dhg26/EyeVu_Hardware_GM2/README.md

# EyeVu_Hardware_GM2
Design docs/designs for GM2 project - EyeVu Hardware

# Parts
- Raspberry Pi 4 - model B
- PiCam v3
