dhg26/EyeVu_Hardware_GM2/Final Product/CAD files/STLs & Images/Mechanism_image_isometric.jpg

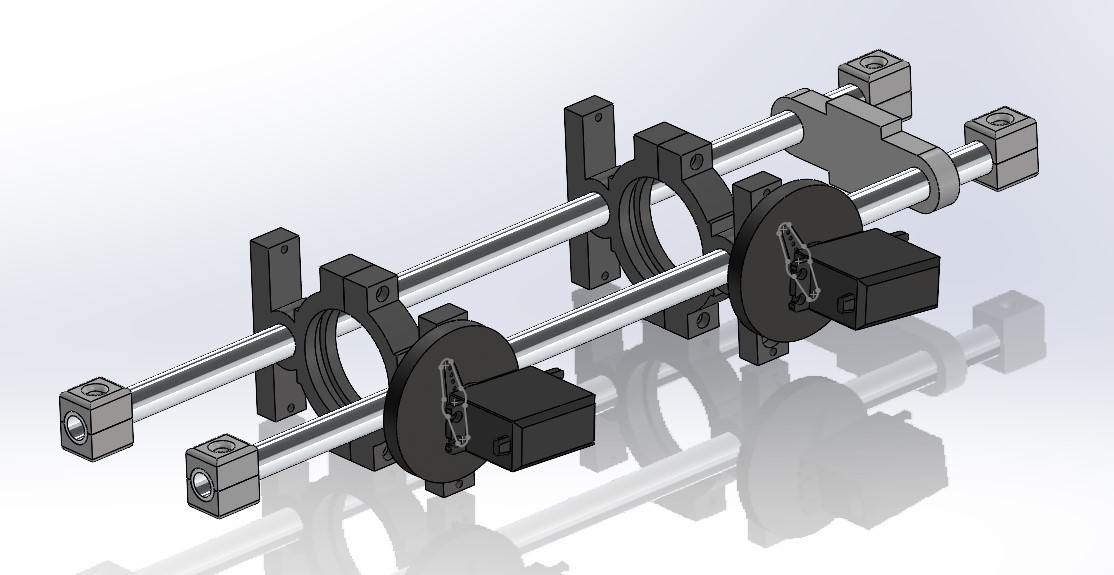
Final Product/CAD files/STLs & Images/Mechanism_image_isometric.jpg
