dhg26/EyeVu_Hardware_GM2/Testing Rig/CAD files/total assembly.SLDASM

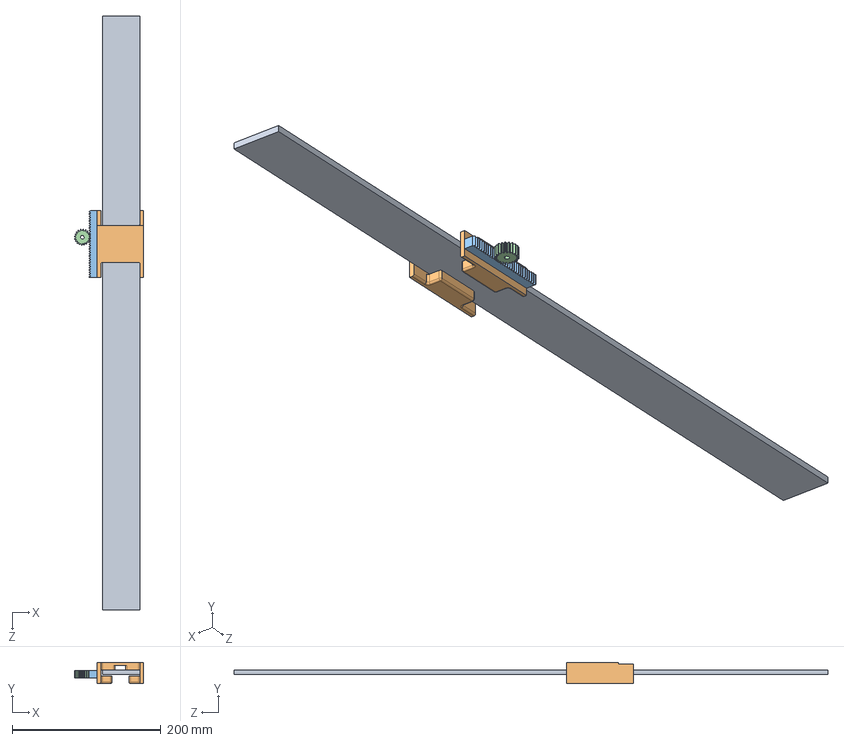
[picture p21: CAD file, 2023-06-08]
Testing Rig/CAD files/total assembly.SLDASM
93.5 x 28.4 x 800.0 mm
aluminium_rod
silder_fixed
rack spur rectangular_iso
spur gear_iso
