dhg26/EyeVu_Hardware_GM2/Alex's work/design_v2/total_assembly_v2.SLDASM

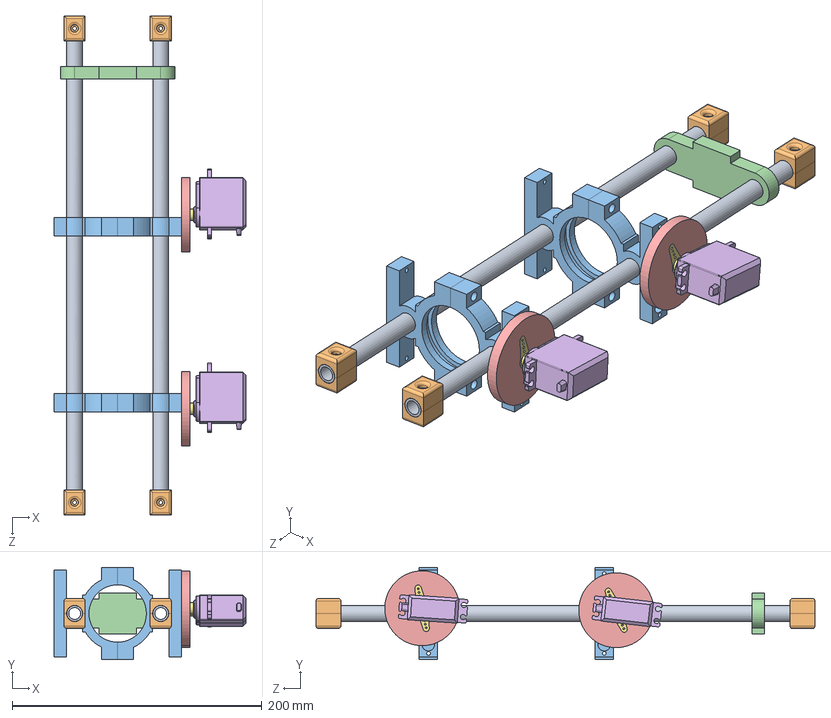
[picture p22: CAD file, 2023-06-08]
Alex's work/design_v2/total_assembly_v2.SLDASM
153.7 x 74.0 x 400.0 mm
alu_rod_19mm_OD x 2
end_bracket_upper x 8
lens_holder_half_modified x 4
camera_holder
mechanism_scotch x 2
MG995 servo motor (found online) x 2
MG995 servo motor horn (found online) x 2
