dhg26/EyeVu_Hardware_GM2/Alex's work/work/GN2_case_assembly.SLDASM

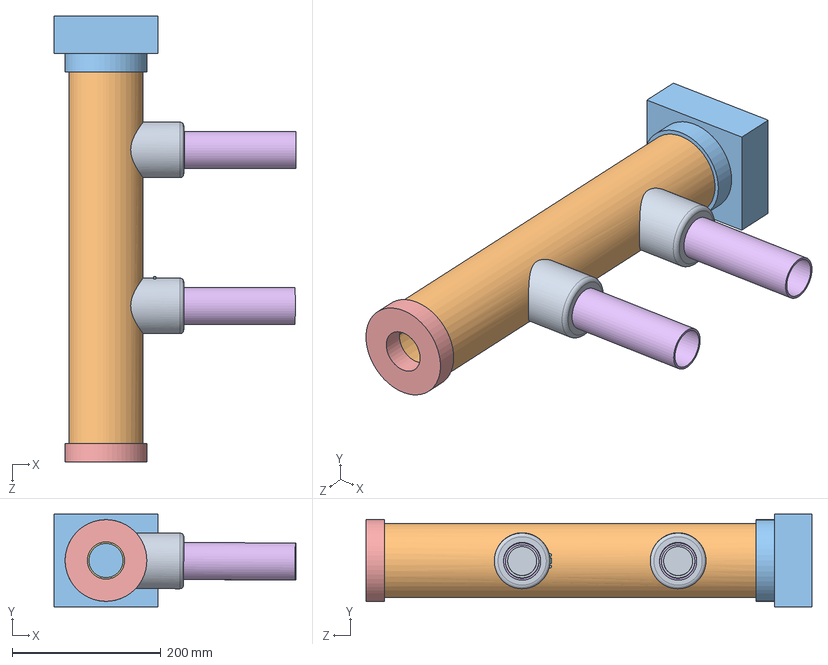
[picture p23: CAD file, 2023-06-08]
Alex's work/work/GN2_case_assembly.SLDASM
325.8 x 125.0 x 600.0 mm
GN2_endpiece2
GN2_rod x 2
GN2_pipe
GN2_handle x 2
GN2_endpiece
GN2_pvc_handle x 2
modified lens holder (only one sided mechanism) x 2
MG995 servo motor (found online)
