dhg26/EyeVu_Hardware_GM2/Testing Rig/CAD files/pinion_gear.SLDASM

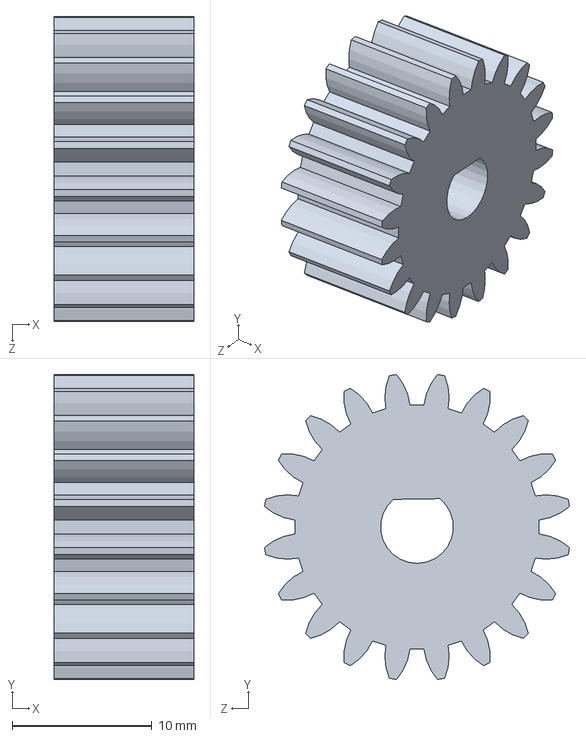
[picture p24: CAD file, 2023-06-08]
Testing Rig/CAD files/pinion_gear.SLDASM
10.0 x 21.8 x 21.8 mm
