dhg26/EyeVu_Hardware_GM2/Alex's work/design_v2/case_assembly.SLDASM

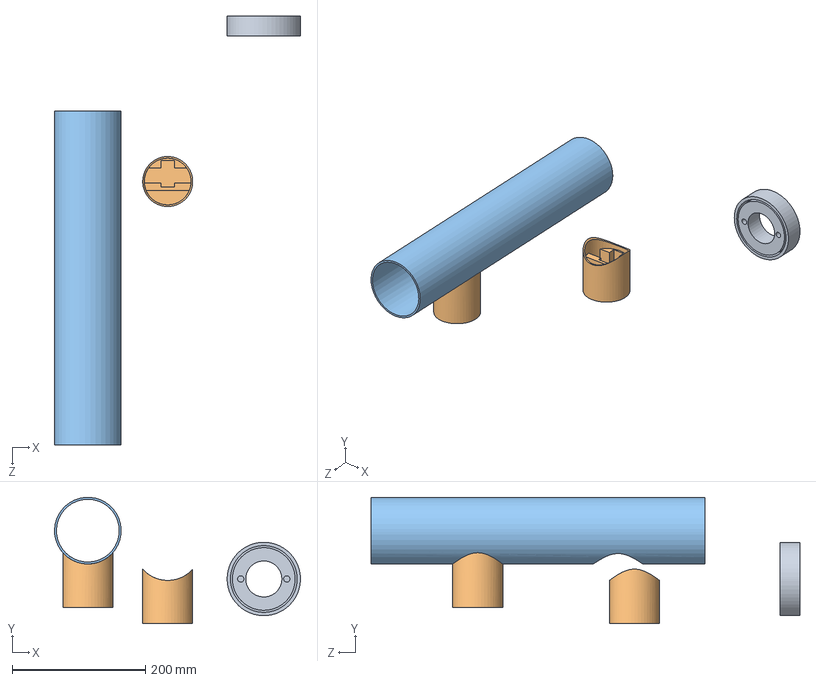
[picture p25: CAD file, 2023-06-08]
Alex's work/design_v2/case_assembly.SLDASM
368.6 x 189.2 x 642.4 mm
handle1 x 2
pipe
pipe_end_cap1
