dhg26/EyeVu_Hardware_GM2/Alex's work/work/square design/GN2_square_assembly.SLDASM

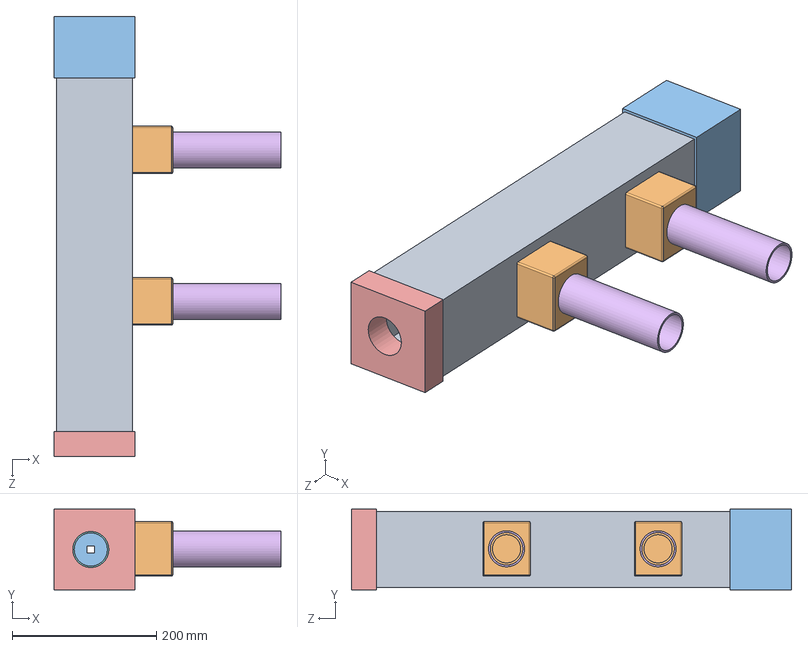
[picture p26: CAD file, 2023-06-08]
Alex's work/work/square design/GN2_square_assembly.SLDASM
314.6 x 112.0 x 610.0 mm
GN2_square_endcap2
GN2_square_handle x 2
GN2_square_pipe
GN2_square_rod x 2
GN2_square_endcap1
GN2_pvc_handle x 2
MG995 servo motor (found online) x 2
modified lens holder (only one sided mechanism) x 2
MG995 servo motor horn (found online) x 2
mechanism_scotch x 2
