dhg26/EyeVu_Hardware_GM2/Testing Rig/CAD files/rack.SLDASM

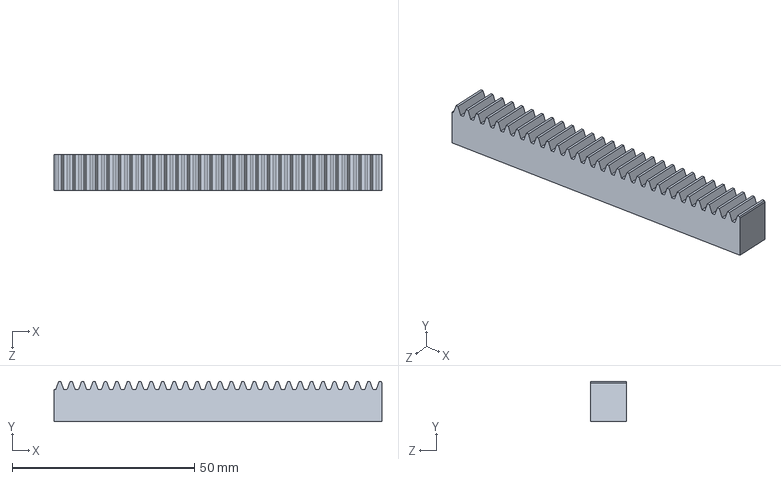
[picture p27: CAD file, 2023-05-28]
Testing Rig/CAD files/rack.SLDASM
90.0 x 11.0 x 10.0 mm
