dhg26/EyeVu_Hardware_GM2/Alex's work/design_v2/modified lens holder (only one sided mechanism).SLDPRT

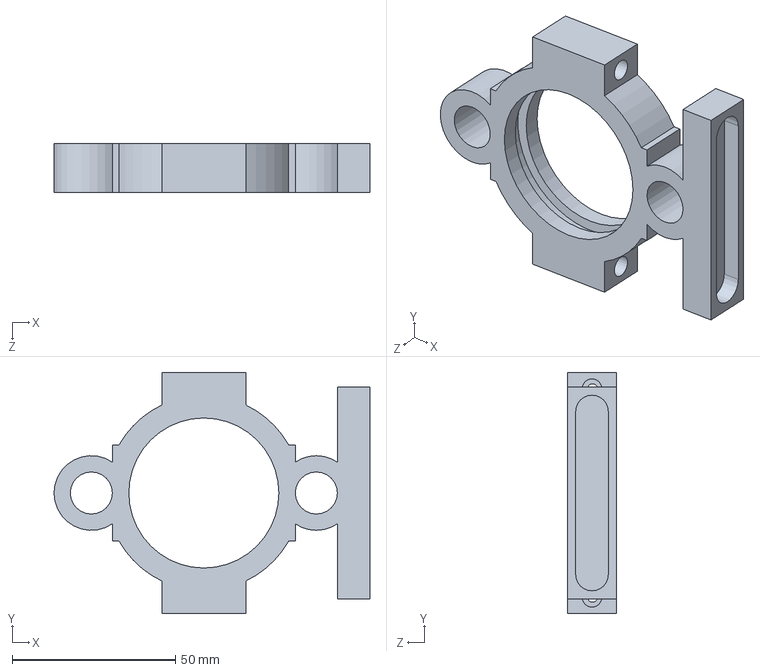
[picture p28: CAD file, 2023-06-08]
Alex's work/design_v2/modified lens holder (only one sided mechanism).SLDPRT
96.9 x 74.0 x 15.0 mm
