dhg26/EyeVu_Hardware_GM2/Alex's work/new/end support.STL

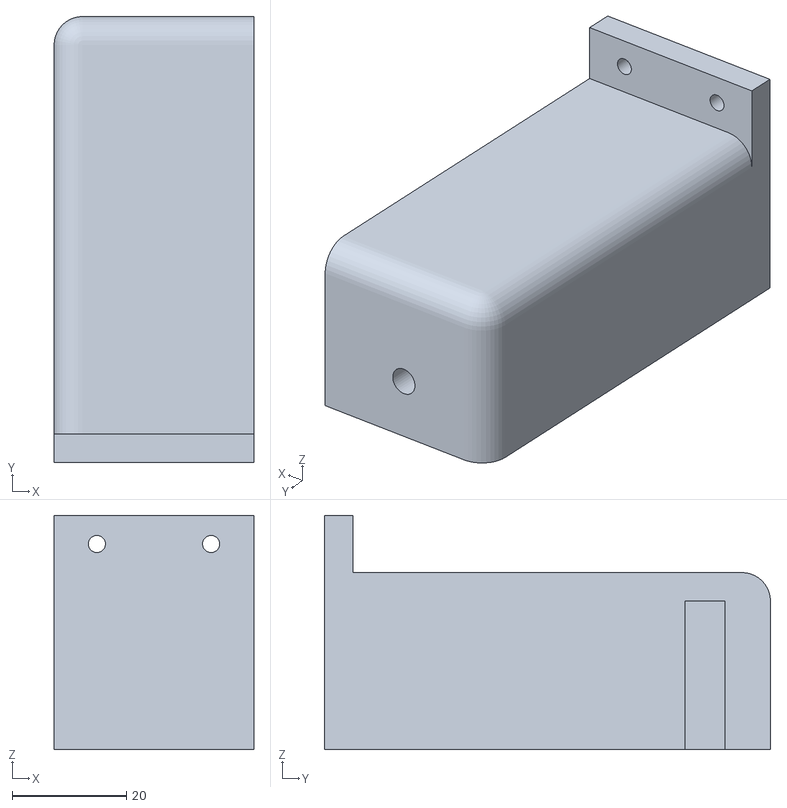
[picture p29: CAD file, 2023-06-08]
Alex's work/new/end support.STL
35.0 x 78.1 x 41.0
