dhg26/EyeVu_Hardware_GM2/Alex's work/work/GN2_endpiece2.SLDPRT

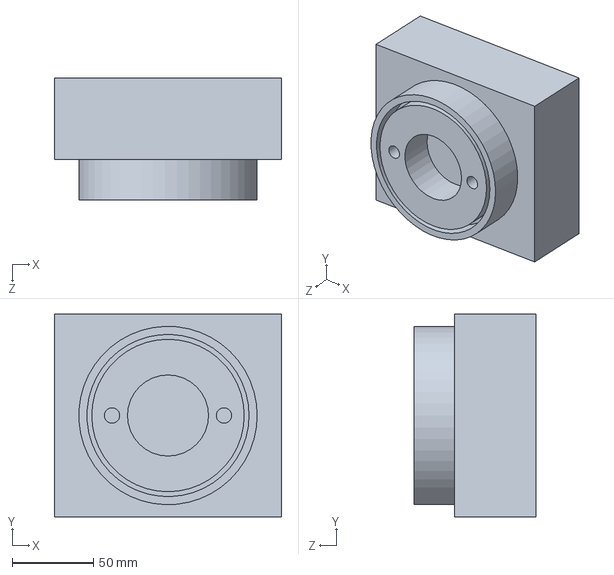
[picture p30: CAD file, 2023-06-08]
Alex's work/work/GN2_endpiece2.SLDPRT
140.0 x 125.0 x 75.0 mm
