dhg26/EyeVu_Hardware_GM2/Alex's work/work/square design/GN2_pvc_handle.SLDPRT

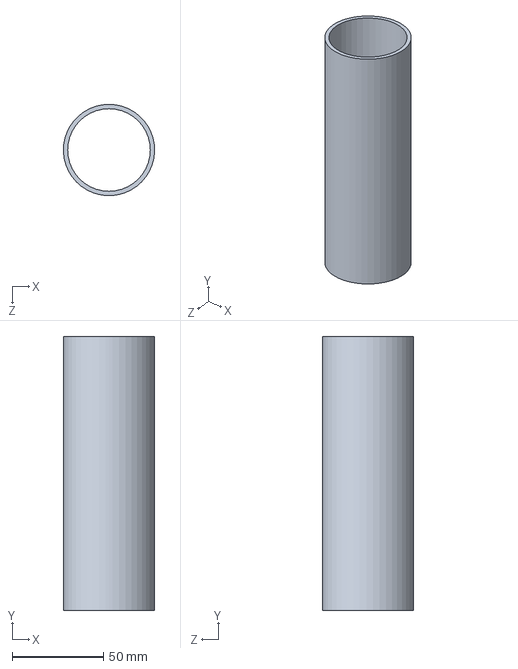
[picture p31: CAD file, 2023-06-08]
Alex's work/work/square design/GN2_pvc_handle.SLDPRT
50.0 x 150.0 x 50.0 mm
