dhg26/EyeVu_Hardware_GM2/Final Product/CAD files/lens_holder_half_w_yoke.SLDPRT

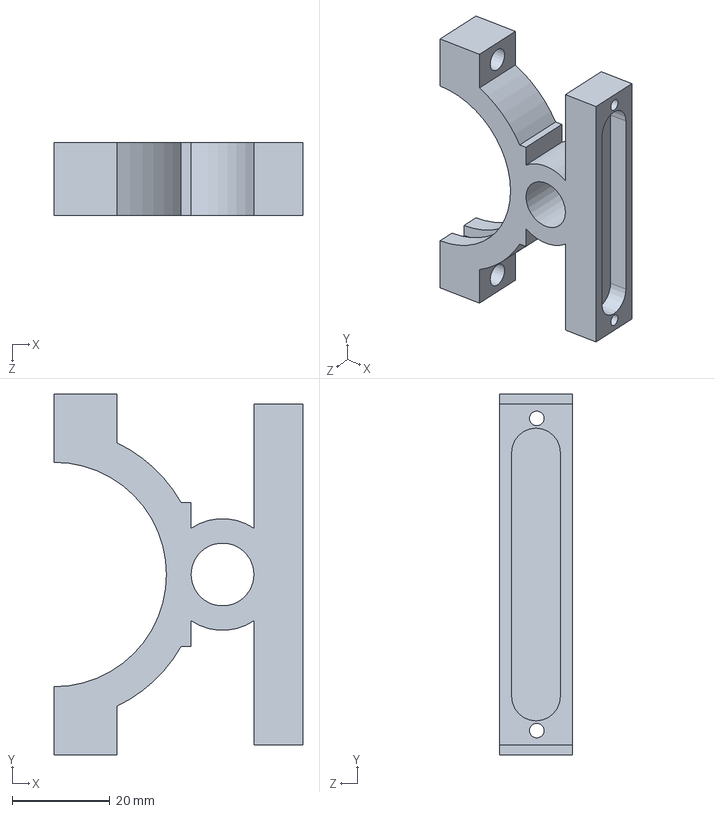
[picture p32: CAD file, 2023-06-08]
Final Product/CAD files/lens_holder_half_w_yoke.SLDPRT
51.0 x 74.0 x 15.0 mm
