dhg26/EyeVu_Hardware_GM2/Final Product/CAD files/STLs & Images/tube_holder_half.STL

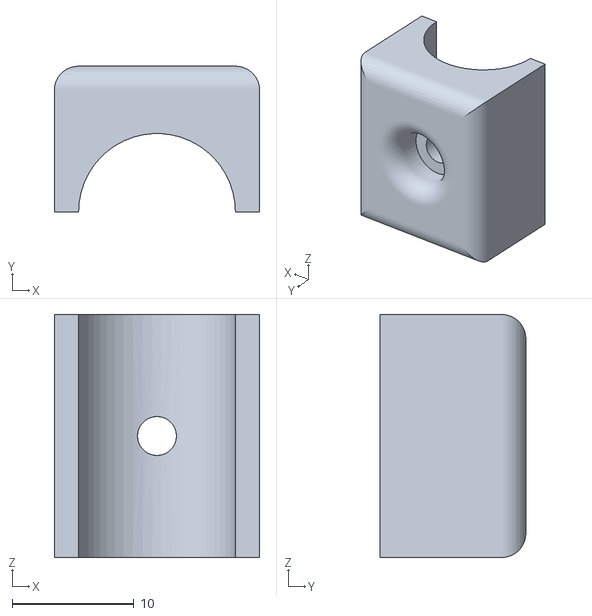
[picture p33: CAD file, 2023-06-08]
Final Product/CAD files/STLs & Images/tube_holder_half.STL
16.9 x 12.0 x 20.0
