dhg26/EyeVu_Hardware_GM2/Alex's work/work/square design/GN2_square_pipe.SLDPRT

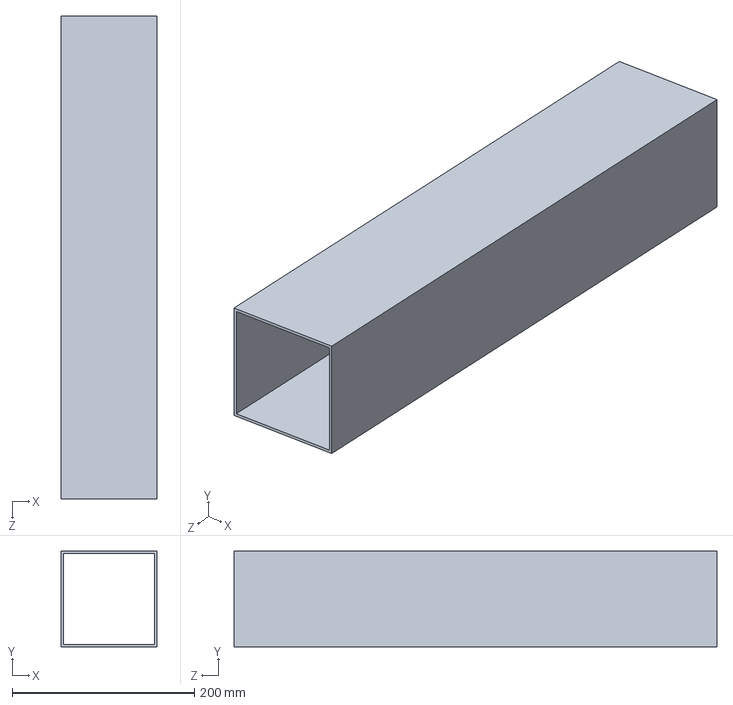
[picture p34: CAD file, 2023-06-08]
Alex's work/work/square design/GN2_square_pipe.SLDPRT
105.0 x 105.0 x 530.0 mm
