dhg26/EyeVu_Hardware_GM2/Final Product/CAD files/disk_w_scotch.SLDPRT

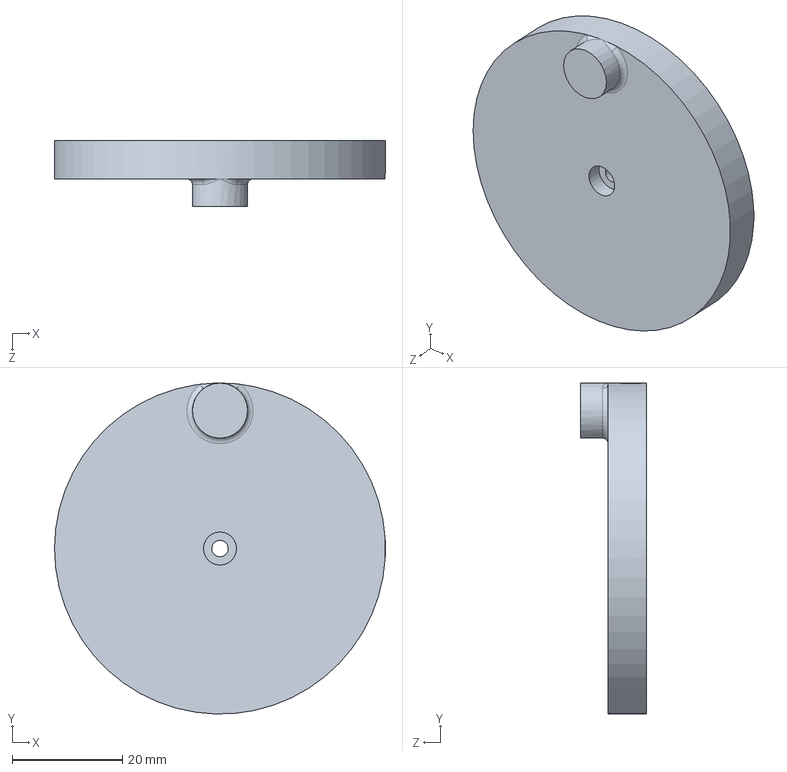
[picture p35: CAD file, 2023-06-08]
Final Product/CAD files/disk_w_scotch.SLDPRT
60.0 x 60.0 x 12.0 mm
