dhg26/EyeVu_Hardware_GM2/Final Product/CAD files/STLs & Images/camera_holder.STL

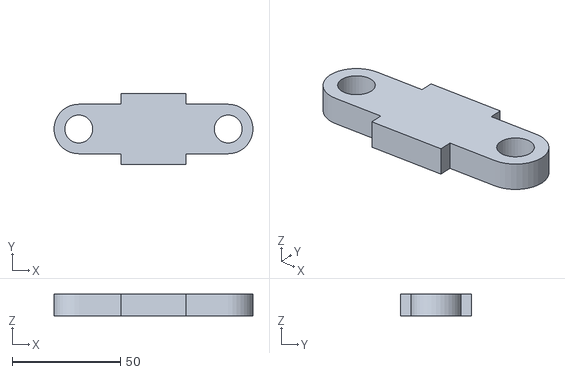
[picture p36: CAD file, 2023-06-08]
Final Product/CAD files/STLs & Images/camera_holder.STL
91.9 x 32.9 x 10.0
