dhg26/EyeVu_Hardware_GM2/Alex's work/design_v2/pipe_end_cap1.SLDPRT

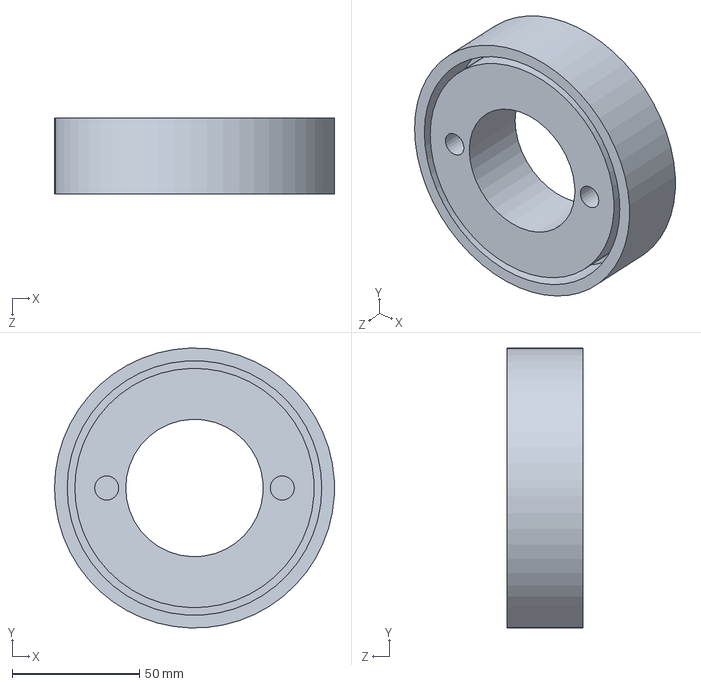
[picture p37: CAD file, 2023-06-08]
Alex's work/design_v2/pipe_end_cap1.SLDPRT
110.0 x 110.0 x 30.0 mm
