dhg26/EyeVu_Hardware_GM2/Alex's work/work/GN2_rod.SLDPRT

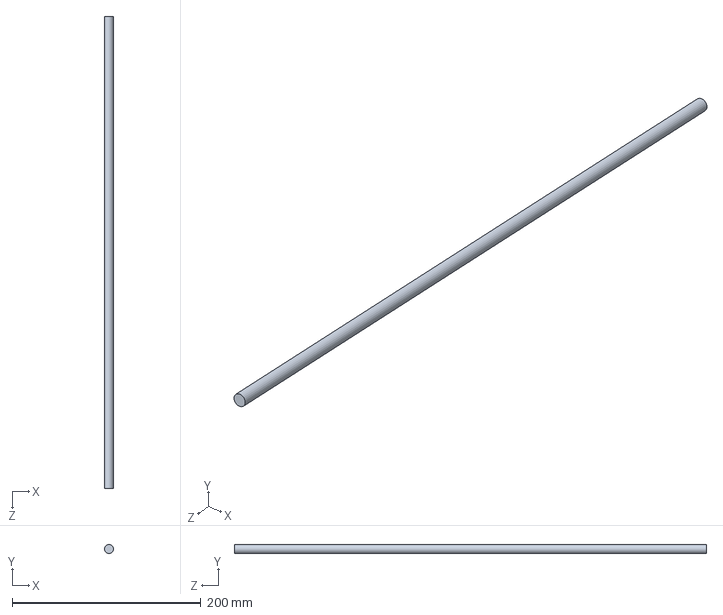
[picture p38: CAD file, 2023-06-08]
Alex's work/work/GN2_rod.SLDPRT
9.50 x 9.50 x 500.0 mm
