dhg26/EyeVu_Hardware_GM2/Alex's work/work/square design/GN2_square_handle.SLDPRT

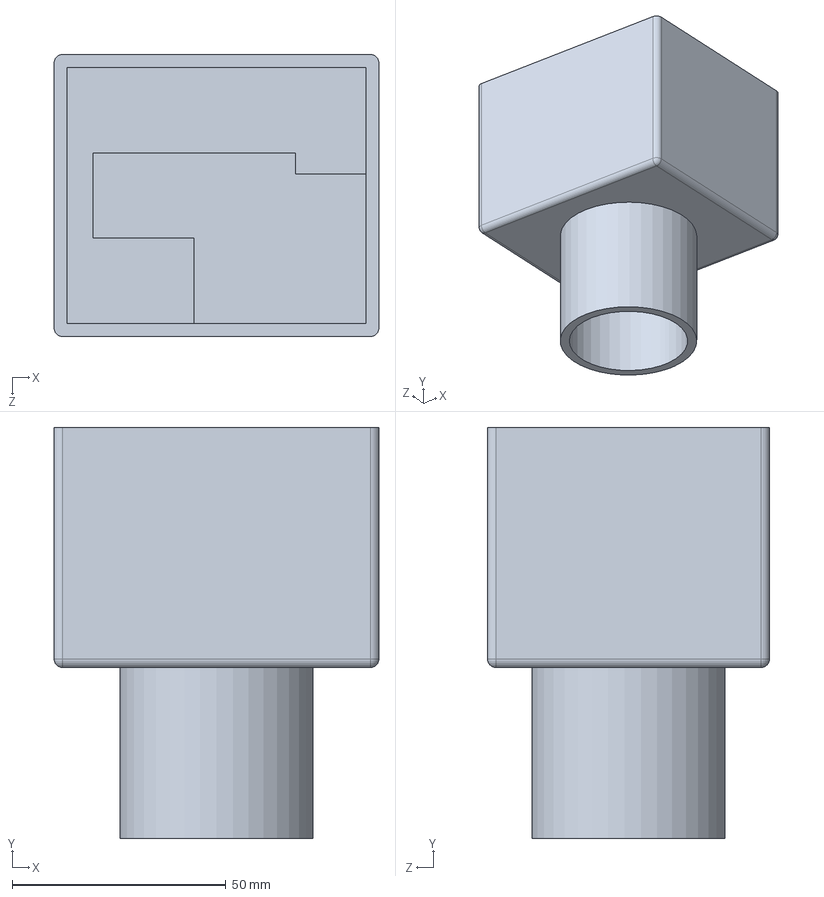
[picture p39: CAD file, 2023-06-08]
Alex's work/work/square design/GN2_square_handle.SLDPRT
76.0 x 96.2 x 66.0 mm
