dhg26/EyeVu_Hardware_GM2/Final Product/CAD files/aluminium_tube.SLDPRT

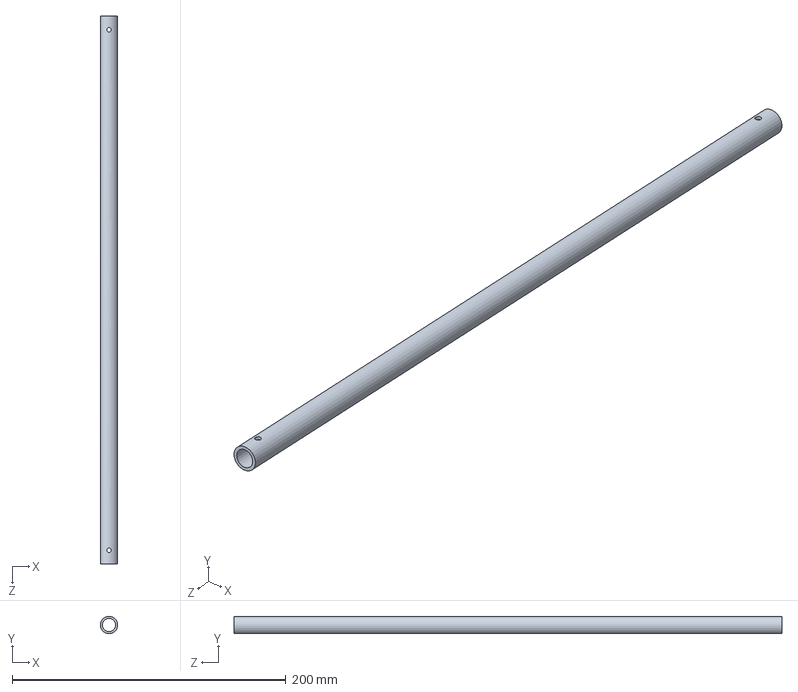
[picture p40: CAD file, 2023-06-08]
Final Product/CAD files/aluminium_tube.SLDPRT
12.7 x 12.7 x 400.0 mm
