dhg26/EyeVu_Hardware_GM2/Testing Rig/CAD files/silder_fixed.SLDPRT

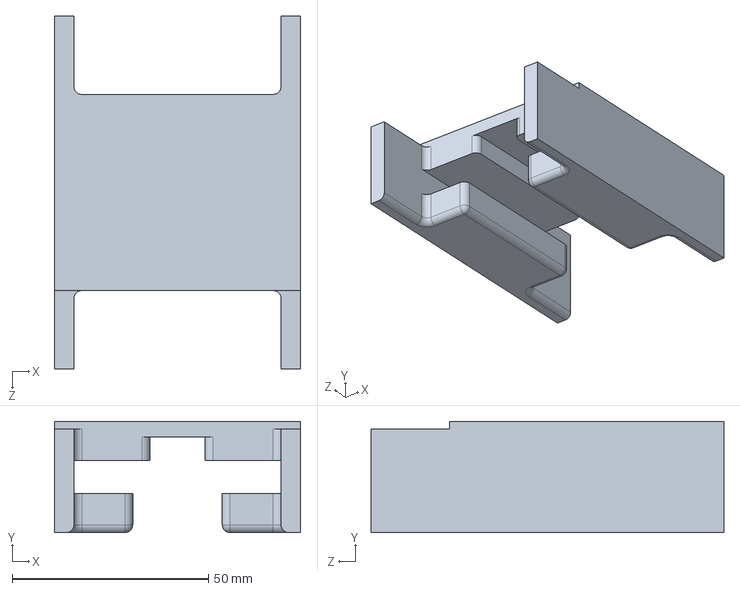
[picture p41: CAD file, 2023-06-08]
Testing Rig/CAD files/silder_fixed.SLDPRT
62.8 x 28.4 x 90.0 mm
