dhg26/EyeVu_Hardware_GM2/Alex's work/new/middle support.SLDPRT

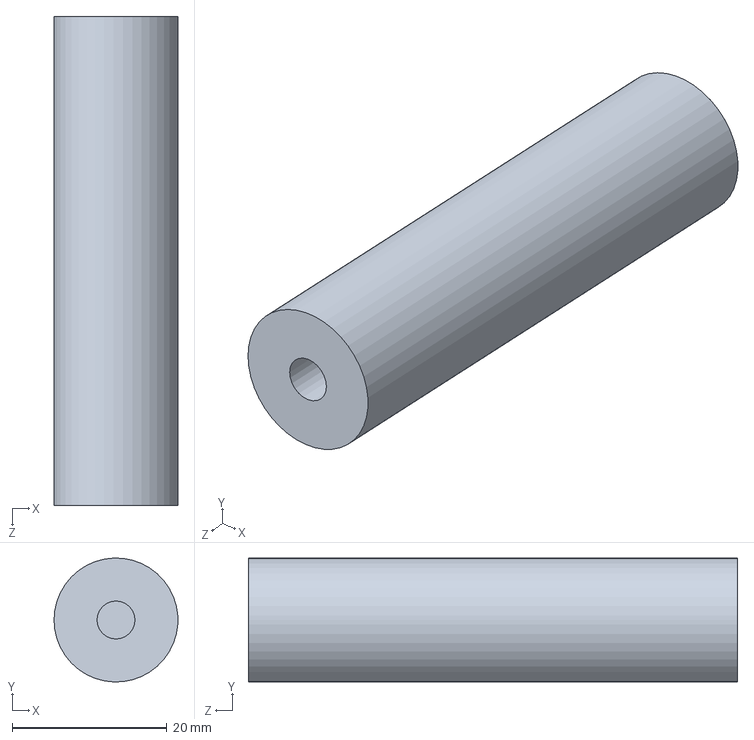
[picture p42: CAD file, 2023-06-01]
Alex's work/new/middle support.SLDPRT
16.0 x 16.0 x 63.1 mm
