dhg26/EyeVu_Hardware_GM2/Testing Rig/CAD files/lens_holder_right_for_auto.SLDPRT

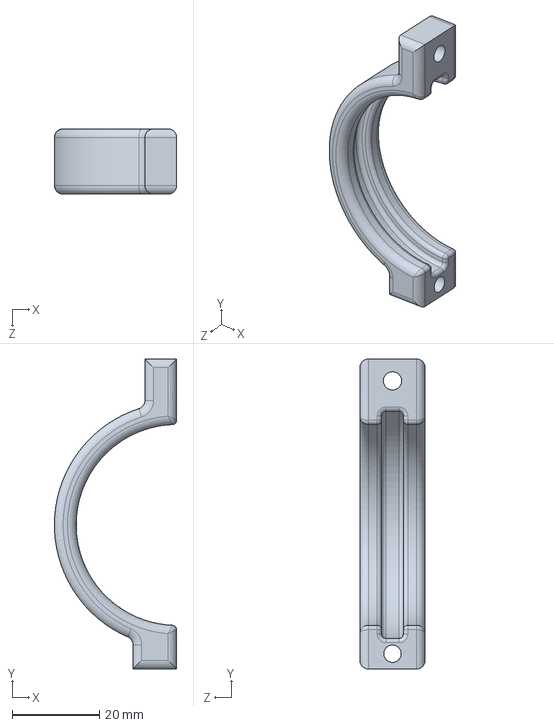
[picture p43: CAD file, 2023-06-08]
Testing Rig/CAD files/lens_holder_right_for_auto.SLDPRT
28.0 x 71.0 x 15.0 mm
