dhg26/EyeVu_Hardware_GM2/Alex's work/new/motorised base plate corrected.DXF

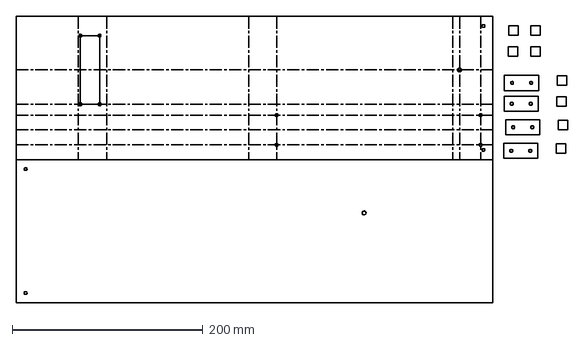
[picture p44: CAD file, 2023-06-01]
Alex's work/new/motorised base plate corrected.DXF
578.7 x 300.0 mm
