dhg26/EyeVu_Hardware_GM2/Alex's work/work/GN2_endpiece.SLDPRT

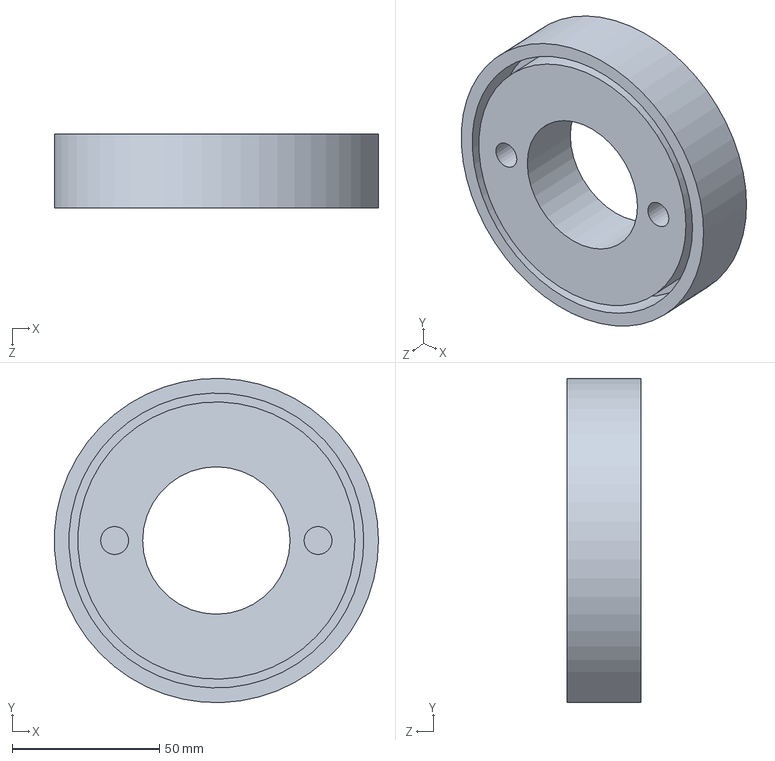
[picture p45: CAD file, 2023-06-08]
Alex's work/work/GN2_endpiece.SLDPRT
109.9 x 110.0 x 25.0 mm
