dhg26/EyeVu_Hardware_GM2/Alex's work/work/square design/GN2_square_rod.SLDPRT

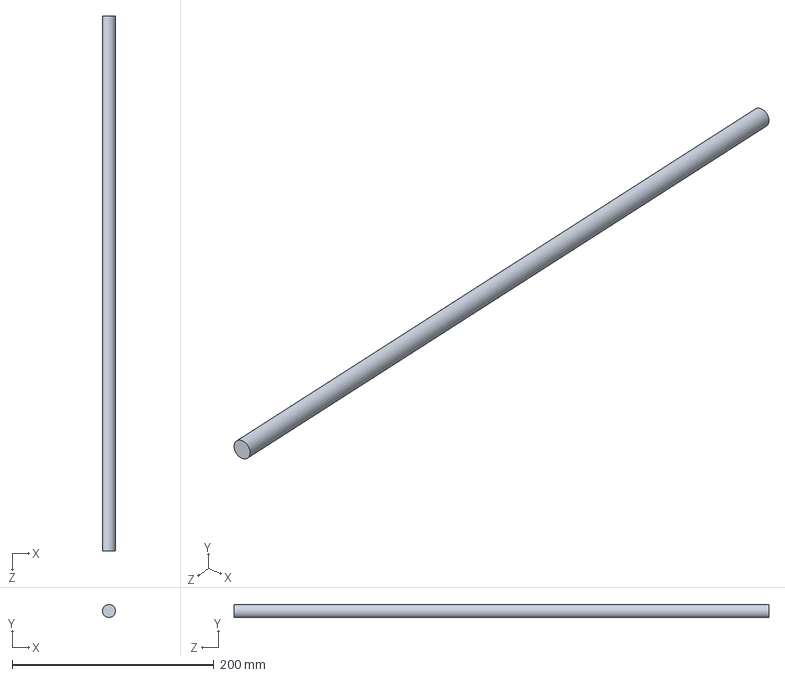
[picture p46: CAD file, 2023-06-08]
Alex's work/work/square design/GN2_square_rod.SLDPRT
12.9 x 12.9 x 530.0 mm
