dhg26/EyeVu_Hardware_GM2/Testing Rig/CAD files/lens_holder_left_for_auto.SLDPRT

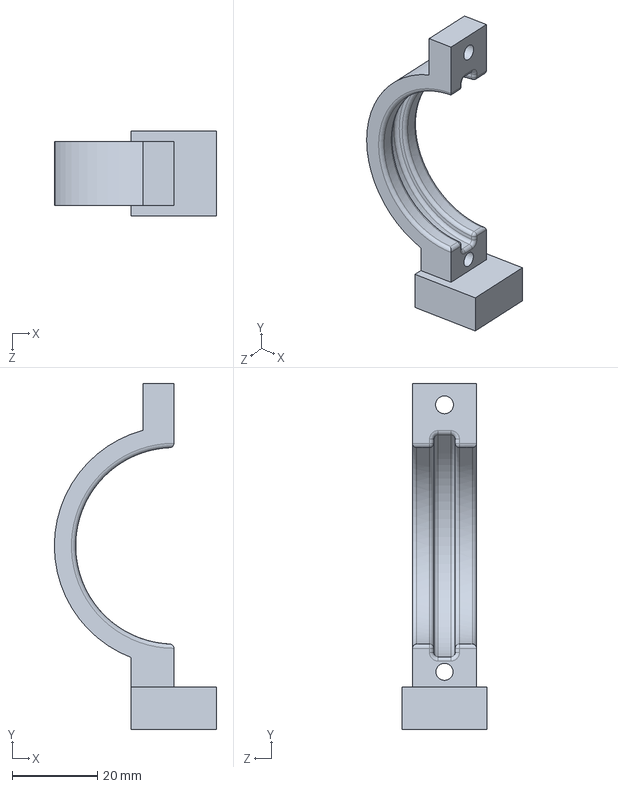
[picture p47: CAD file, 2023-06-08]
Testing Rig/CAD files/lens_holder_left_for_auto.SLDPRT
38.0 x 81.0 x 20.0 mm
