dhg26/EyeVu_Hardware_GM2/Alex's work/design_v2/pipe.SLDPRT

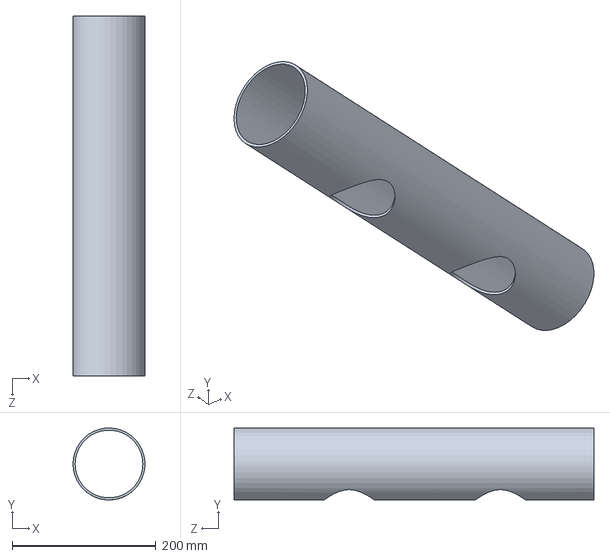
[picture p48: CAD file, 2023-06-08]
Alex's work/design_v2/pipe.SLDPRT
100.0 x 100.0 x 500.0 mm
