dhg26/EyeVu_Hardware_GM2/Alex's work/new/Part2.SLDPRT

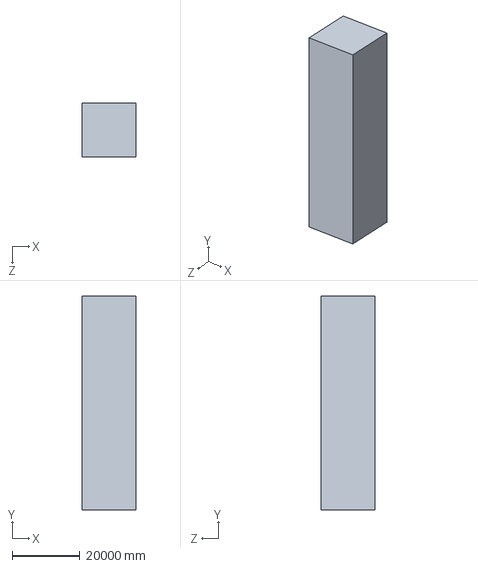
[picture p49: CAD file, 2023-06-01]
Alex's work/new/Part2.SLDPRT
16000.0 x 63100.0 x 16000.0 mm
