dhg26/EyeVu_Hardware_GM2/Alex's work/work/GN2_pipe.SLDPRT

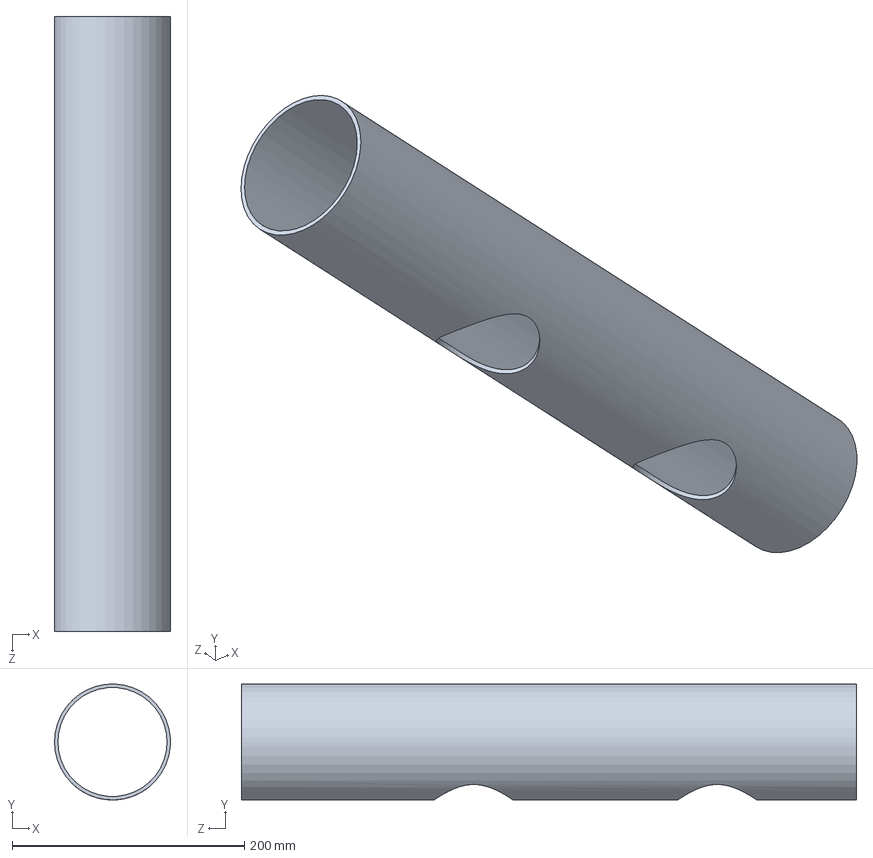
[picture p50: CAD file, 2023-06-08]
Alex's work/work/GN2_pipe.SLDPRT
100.0 x 100.0 x 530.0 mm
