dhg26/EyeVu_Hardware_GM2/Alex's work/design_v2/handle1.SLDPRT

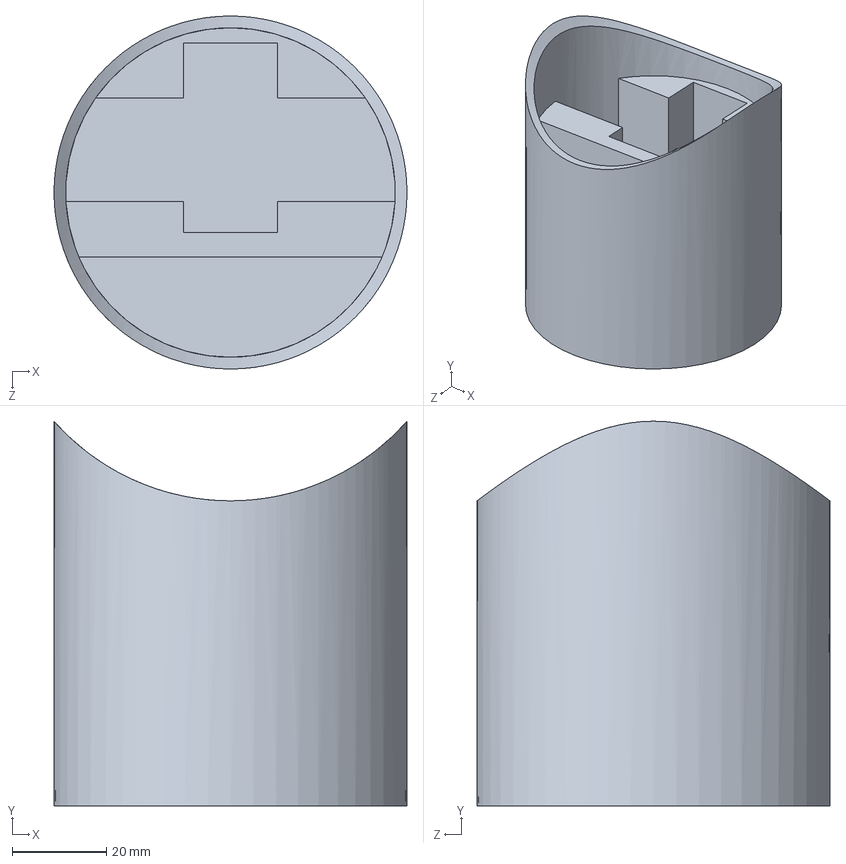
[picture p52: CAD file, 2023-06-08]
Alex's work/design_v2/handle1.SLDPRT
75.0 x 81.7 x 75.0 mm
