dhg26/EyeVu_Hardware_GM2/Alex's work/new/motorised base plate.DXF

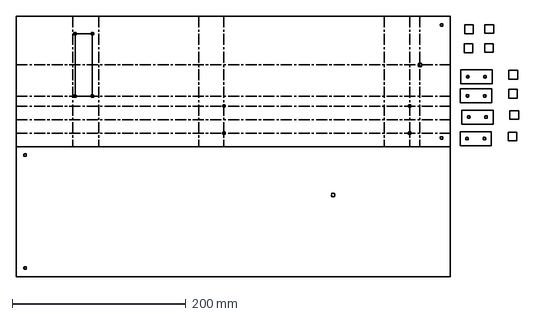
[picture p53: CAD file, 2023-06-01]
Alex's work/new/motorised base plate.DXF
578.7 x 300.0 mm
