dhg26/EyeVu_Hardware_GM2/Alex's work/work/GN2_handle.SLDPRT

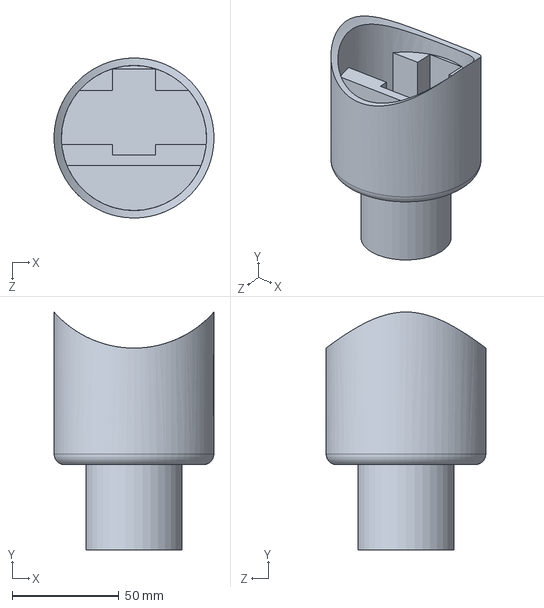
[picture p54: CAD file, 2023-06-08]
Alex's work/work/GN2_handle.SLDPRT
75.0 x 111.6 x 75.0 mm
