dhg26/EyeVu_Hardware_GM2/Alex's work/work/square design/GN2_square_endcap1.SLDPRT

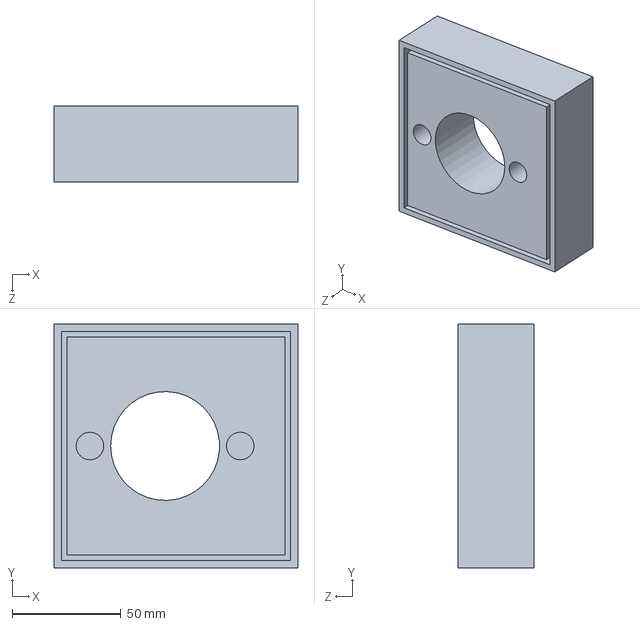
[picture p55: CAD file, 2023-06-08]
Alex's work/work/square design/GN2_square_endcap1.SLDPRT
112.0 x 112.0 x 35.0 mm
