dhg26/EyeVu_Hardware_GM2/Testing Rig/CAD files/aluminium_rod.SLDPRT

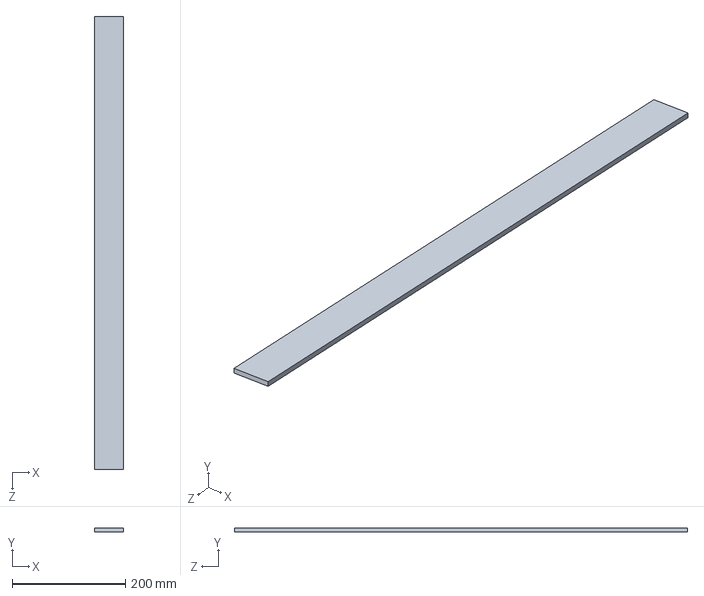
[picture p56: CAD file, 2023-05-28]
Testing Rig/CAD files/aluminium_rod.SLDPRT
50.8 x 6.35 x 800.0 mm
