dhg26/EyeVu_Hardware_GM2/Alex's work/new/motorholder.SLDPRT

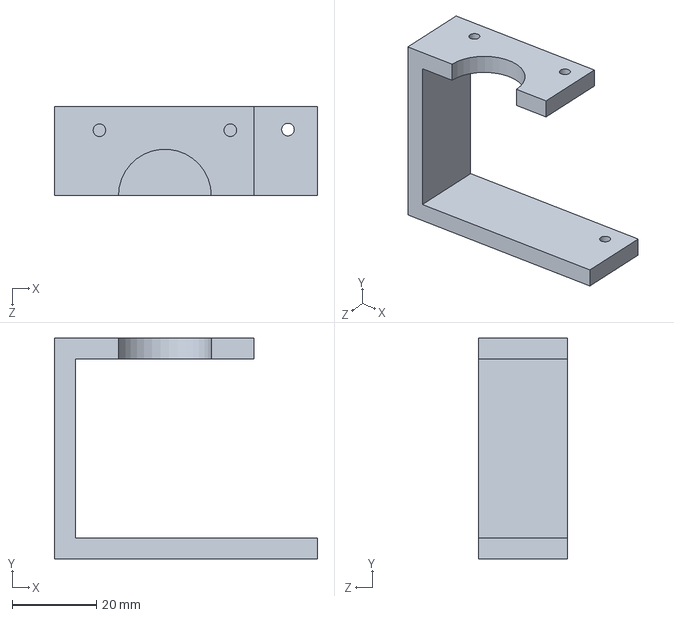
[picture p57: CAD file, 2023-06-01]
Alex's work/new/motorholder.SLDPRT
62.3 x 52.3 x 21.1 mm
