dhg26/EyeVu_Hardware_GM2/Final Product/CAD files/50mm_biconvex_lens_model.SLDPRT

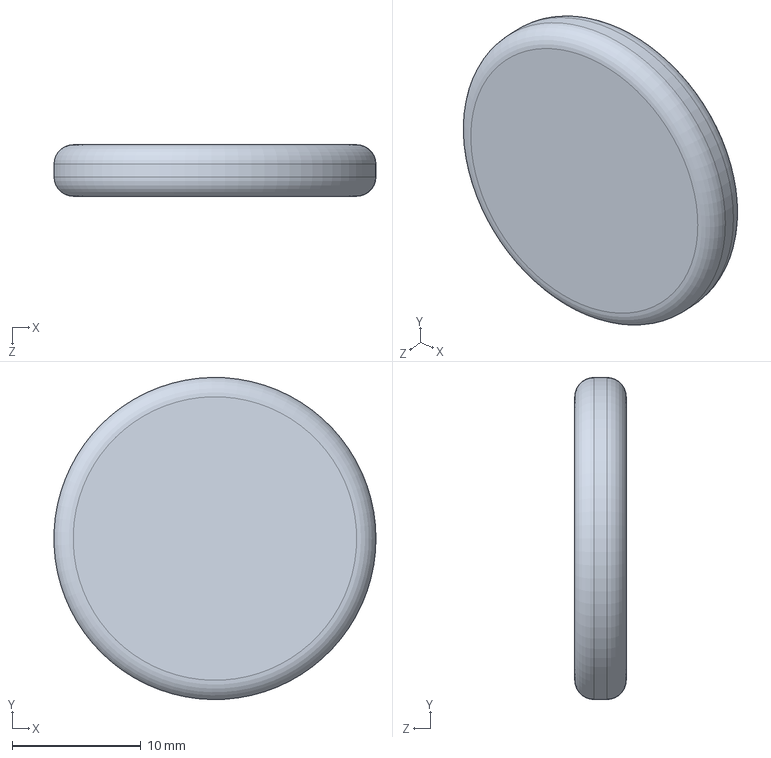
[picture p58: CAD file, 2023-06-08]
Final Product/CAD files/50mm_biconvex_lens_model.SLDPRT
25.0 x 25.0 x 4.00 mm
