dhg26/EyeVu_Hardware_GM2/Alex's work/design_v2/MG995 servo motor horn (found online) .SLDPRT

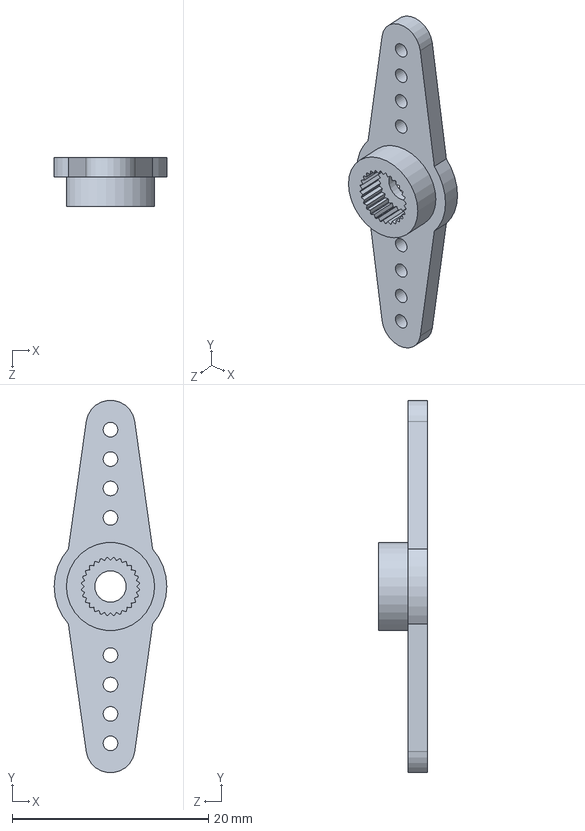
[picture p59: CAD file, 2023-06-08]
Alex's work/design_v2/MG995 servo motor horn (found online) .SLDPRT
11.5 x 38.0 x 5.00 mm
