dhg26/EyeVu_Hardware_GM2/Testing Rig/CAD files/lens_holder_left.SLDPRT

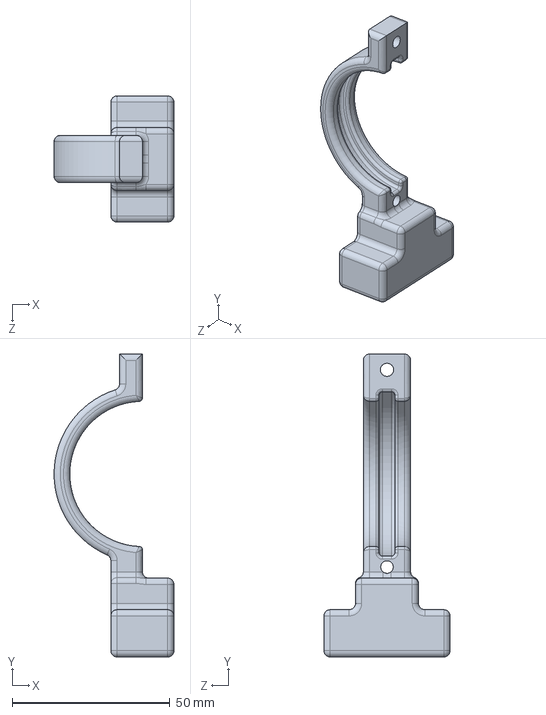
[picture p60: CAD file, 2023-05-28]
Testing Rig/CAD files/lens_holder_left.SLDPRT
38.0 x 96.0 x 40.0 mm
