dhg26/EyeVu_Hardware_GM2/Alex's work/design_v2/MG995 servo motor (found online).sldprt

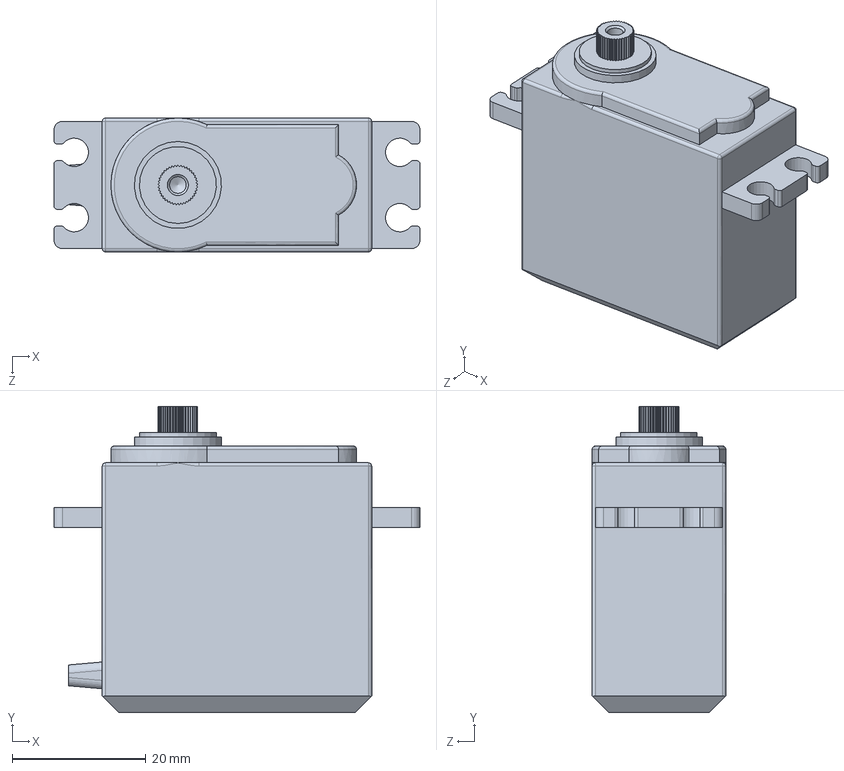
[picture p61: CAD file, 2023-06-08]
Alex's work/design_v2/MG995 servo motor (found online).sldprt
54.7 x 45.7 x 20.0 mm
