dhg26/EyeVu_Hardware_GM2/Testing Rig/CAD files/camera_mount.SLDPRT

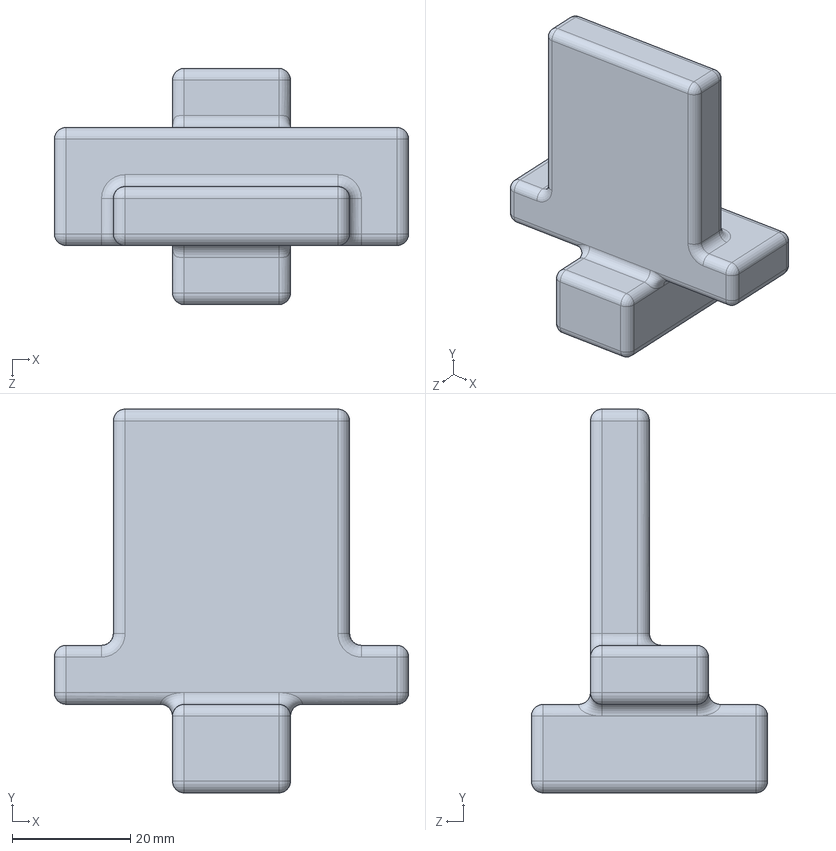
[picture p62: CAD file, 2023-05-28]
Testing Rig/CAD files/camera_mount.SLDPRT
60.0 x 65.0 x 40.0 mm
