dhg26/EyeVu_Hardware_GM2/(list of files, cad)

Other CAD files:
Final Product/CAD files/total_assembly.SLDASM
Alex's work/motorised base plate corrected.SLDPRT
Alex's work/motorised base plate.SLDPRT
Alex's work/new/test base plate static.SLDPRT
Alex's work/new/end holder.SLDPRT
Final Product/CAD files/STLs & Images/disk_w_scotch.STL
Alex's work/work/GN2_pvc_handle.SLDPRT
Final Product/CAD files/STLs & Images/lens_holder_half_w_yoke.STL
Alex's work/design_v2/rail.SLDPRT
Final Product/CAD files/modified lens holder (only one sided mechanism).SLDPRT
Final Product/CAD files/camera_holder.SLDPRT
Final Product/CAD files/tube_holder_half.SLDPRT
Alex's work/design_v2/mechanism_scotch.SLDPRT
Testing Rig/CAD files/lens_holder_right.SLDPRT
Alex's work/new/end holder.STL
Alex's work/new/middle support.STL
Alex's work/new/motorholder.STL
