dhg26/EyeVu_Hardware_GM2/Testing Rig/block diagram of full system.pdf

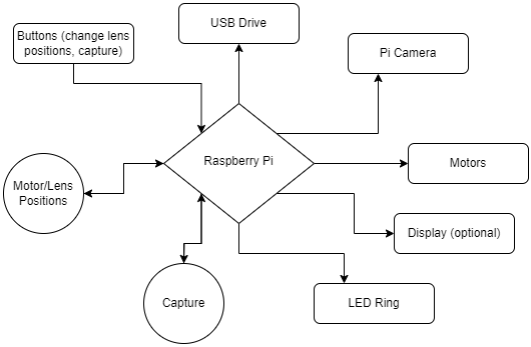
[picture p69: figure]
