dhg26/EyeVu_Hardware_GM2/Testing Rig/Photos/2023-05-31-173207_2560x1440_scrot.png

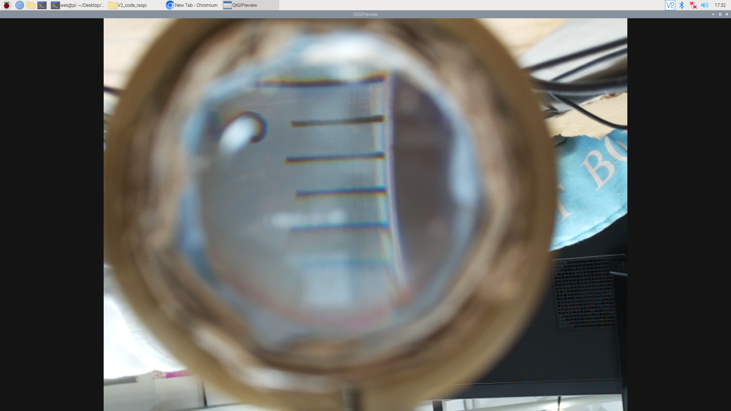
Testing Rig/Photos/2023-05-31-173207_2560x1440_scrot.png
