dhg26/EyeVu_Hardware_GM2/Testing Rig/Photos/2023-06-01-120918_2560x1440_scrot.png

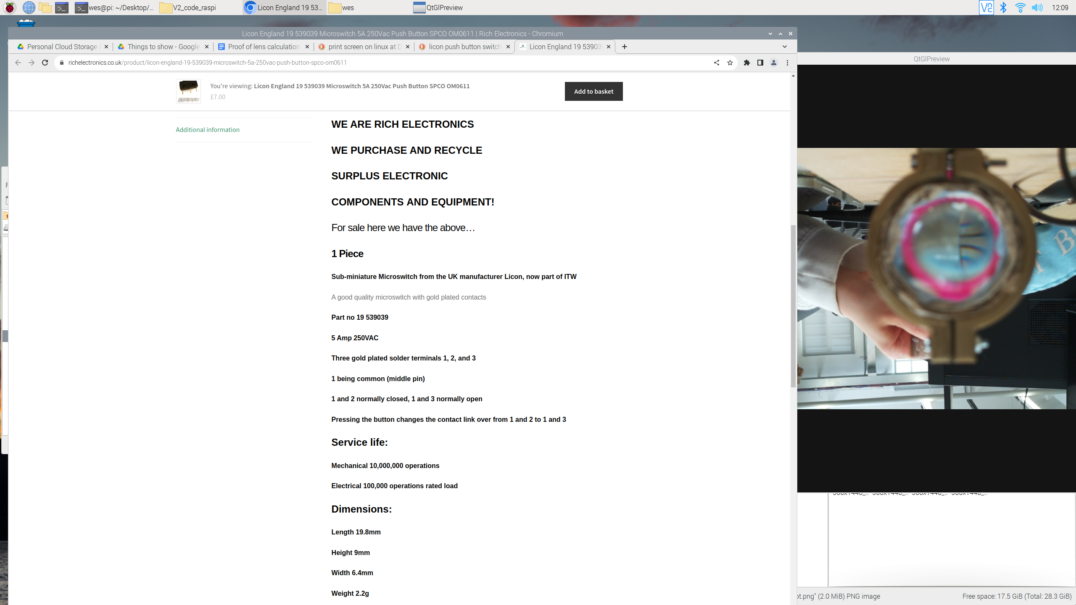
Testing Rig/Photos/2023-06-01-120918_2560x1440_scrot.png
