dhg26/EyeVu_Hardware_GM2/(commit log)

2023-05-22 Add files via upload
    Lens holder for experimental jig - GM2
    [gm2_jig_lens_holder_left.SLDPRT, gm2_jig_lens_holder_right.SLDPRT]
2023-05-24 initial
    Creating initial testing script to test performance of optics system and RasPi camera V3.
2023-05-24 Create camera_setting_functions
2023-05-25 buttons
    buttons for use of camera settings without display
2023-05-25 extra button for capture
2023-05-28 mechanism for motorised version
    Includes rack & pinion mechanism, metal rod and slider
    [gm2_jig_lens_holder_left.SLDPRT, gm2_jig_lens_holder_right.SLDPRT, gm2_raspi_camera_jib.SLDPRT, metal rod.SLDPRT, pinion_gear.SLDASM, rack.SLDASM, slider.SLDPRT, total assembly.SLDASM]
2023-05-31 fixed slider - height dimension needed adjustment
    [silder_fixed.SLDPRT, slider.STL]
2023-05-31 fixed structure of repo and added fixed raspi code
    [gm2_jig_lens_holder_left.SLDPRT, gm2_jig_lens_holder_right.SLDPRT, gm2_raspi_camera_jib.SLDPRT, metal rod.SLDPRT, pinion_gear.SLDASM, rack.SLDASM, silder_fixed.SLDPRT, slider.SLDPRT]
2023-05-31 design v2 initial commit
    [alu_rod_19mm_OD.SLDPRT, end_bracket_upper.SLDPRT, lens_holder_half.SLDPRT, total_assembly_v2.SLDASM]
2023-06-01 Lens holder and width updated
    [MG995 servo motor (found online).sldprt, camera_holder.SLDPRT, end_bracket_upper.SLDPRT, lens_holder_half.SLDPRT, lens_holder_half_modified.SLDPRT, total_assembly_v2.SLDASM]
2023-06-01 servo motor added
    [MG995 servo motor (found online).sldprt, MG995 servo motor horn (found online) .SLDPRT, mechanism_scotch.SLDPRT, total_assembly_v2.SLDASM]
2023-06-01 new parts for motorised
    [Part2.SLDPRT, end holder.SLDPRT, end holder.STL, middle support.SLDPRT, middle support.STL, motorholder.SLDPRT, motorholder.STL, motorised base plate corrected.DXF]
2023-06-03 modified lens holder for automated jig
    [gm2_jig_lens_holder_left_for_auto.SLDPRT, gm2_jig_lens_holder_left_for_auto.STL, gm2_jig_lens_holder_right_for_auto.SLDPRT, gm2_jig_lens_holder_right_for_auto.STL, total_assembly_v2.SLDASM]
2023-06-04 single sided mechanism lens holder CAD
    [modified lens holder (only one sided mechanism).SLDPRT]
2023-06-05 appearance changes for rendering
    [alu_rod_19mm_OD.SLDPRT, camera_holder.SLDPRT, end_bracket_upper.SLDPRT, lens_holder_half_modified.SLDPRT, mechanism_scotch.SLDPRT, total_assembly_v2.SLDASM]
2023-06-05 Re-arranged repo structure for final output submission
    [Lens model.SLDPRT, MG995 servo motor (found online).sldprt, MG995 servo motor horn (found online) .SLDPRT, alu_rod_19mm_OD.SLDPRT, camera_holder.SLDPRT, end_bracket_upper.SLDPRT, gm2_jig_lens_holder_left.SLDPRT, gm2_jig_lens_holder_left_for_auto.SLDPRT]
2023-06-05 more changes
    [50mm_biconvex_lens_model.SLDPRT, MG995_servo_motor_(found_online).sldprt, MG995_servo_motor_horn_(found_online).SLDPRT, aluminium_tube.SLDPRT, camera_holder.SLDPRT, disk_w_scotch.SLDPRT, lens_holder_half_w_yoke.SLDPRT, total_assembly.SLDASM]
2023-06-05 corrected folder name
    [gm2_jig_lens_holder_left.SLDPRT, gm2_jig_lens_holder_left_for_auto.SLDPRT, gm2_jig_lens_holder_right.SLDPRT, gm2_jig_lens_holder_right_for_auto.SLDPRT, gm2_raspi_camera_jib.SLDPRT, metal rod.SLDPRT, pinion_gear.SLDASM, rack.SLDASM]
2023-06-05 new files
    [GN2_case_assembly.SLDASM, GN2_endpiece.SLDPRT, GN2_endpiece2.SLDPRT, GN2_handle.SLDPRT, GN2_pipe.SLDPRT, GN2_pvc_handle.SLDPRT, GN2_rod.SLDPRT, GN2_square_assembly.SLDASM]
2023-06-05 fixed rig files
    [aluminium_rod.SLDPRT, camera_mount.SLDPRT, lens_holder_left.SLDPRT, lens_holder_left_for_auto.SLDPRT, lens_holder_right.SLDPRT, lens_holder_right_for_auto.SLDPRT, pinion_gear.SLDASM, slider.SLDPRT]
2023-06-05 re-arranged repo
    [aluminium_rod.SLDPRT, camera_mount.SLDPRT, lens_holder_left.SLDPRT, lens_holder_left_for_auto.SLDPRT, lens_holder_right.SLDPRT, lens_holder_right_for_auto.SLDPRT, pinion_gear.SLDASM, rack.SLDASM]
2023-06-07 lens design
2023-06-08 cad update
2023-06-08 changes from files on dyson centre
    [case_assembly.SLDASM, end holder.SLDPRT, end support.STL, handle1.SLDPRT, motorised base plate corrected.SLDPRT, pipe.SLDPRT, pipe_end_cap1.SLDPRT, rail.SLDPRT]
2023-06-08 moving files
    [Part2.SLDPRT, end holder.SLDPRT, end holder.STL, end support.STL, middle support.SLDPRT, middle support.STL, motorholder.SLDPRT, motorholder.STL]
2023-06-08 clean repo
    [metal rod.SLDPRT, pinion_gear.SLDASM, rack.SLDASM, slider.SLDPRT, total assembly.SLDASM]
2023-06-08 fixed the repo
    [GN2_case_assembly.SLDASM, GN2_endpiece.SLDPRT, GN2_endpiece2.SLDPRT, GN2_handle.SLDPRT, GN2_pipe.SLDPRT, GN2_pvc_handle.SLDPRT, GN2_rod.SLDPRT, GN2_square_assembly.SLDASM]
